haliltepedelen/Sic-Mosfet-Based-Three-Phase-Inverter-Power-Board/IMG_20200712_010313.jpg

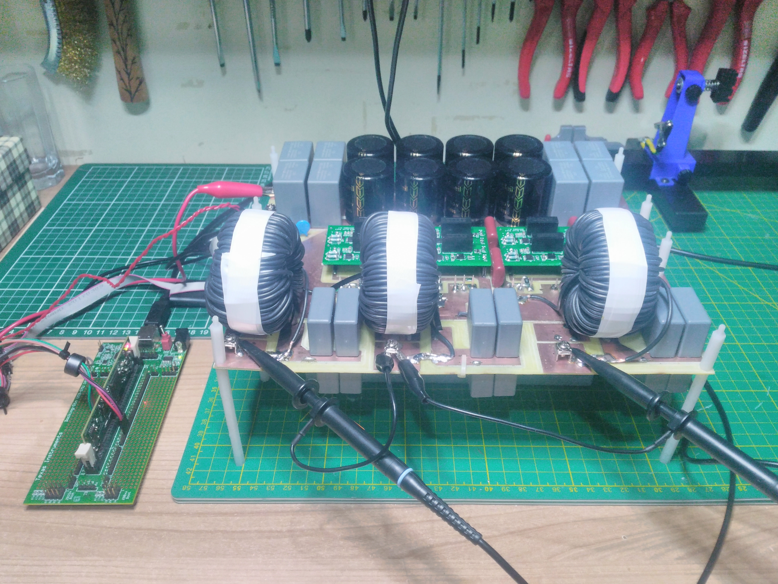
IMG_20200712_010313.jpg
