haliltepedelen/Sic-Mosfet-Based-Three-Phase-Inverter-Power-Board/README.md

# Sic-Mosfet-Based-Three-Phase-Inverter-Power-Board
Sic Mosfet Based Three Phase Inverter Power Board
Capture
