haliltepedelen/Sic-Mosfet-Based-Three-Phase-Inverter-Power-Board/(list of files, drawings)

Other design files:
Sic_PowerBoard.PcbDoc
Sic_PowerBoard.PcbLib
Sic_PowerBoard.PrjPcb
Sic_PowerBoard.SchDoc
Sic_PowerBoard.SchLib
